inaxeon/Updi-Key/KiCad/Updifier/UpdiKey.pdf

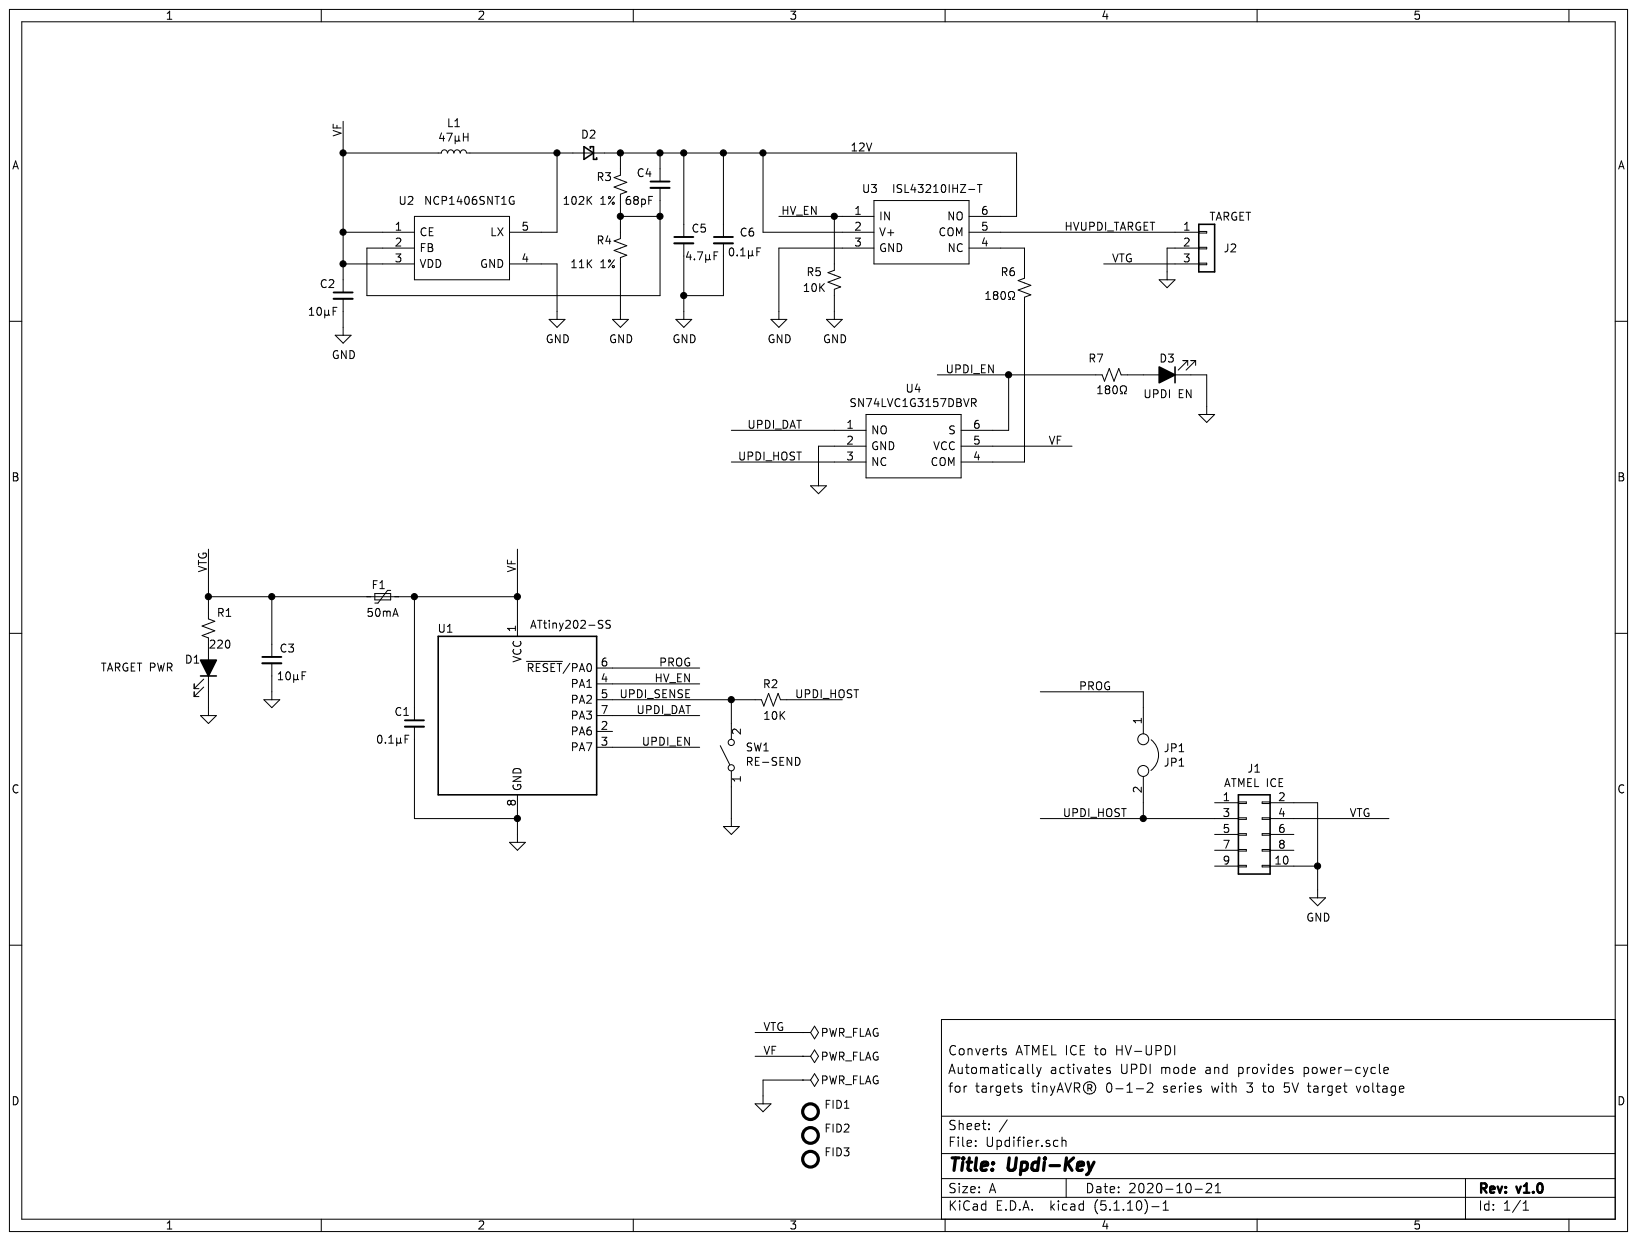
[picture p1: page 1]
