inaxeon/Updi-Key/KiCad/Updifier/Updifier.kicad_pcb

## KiCad design KiCad/Updifier/Updifier.kicad_pcb (2021-10-28)

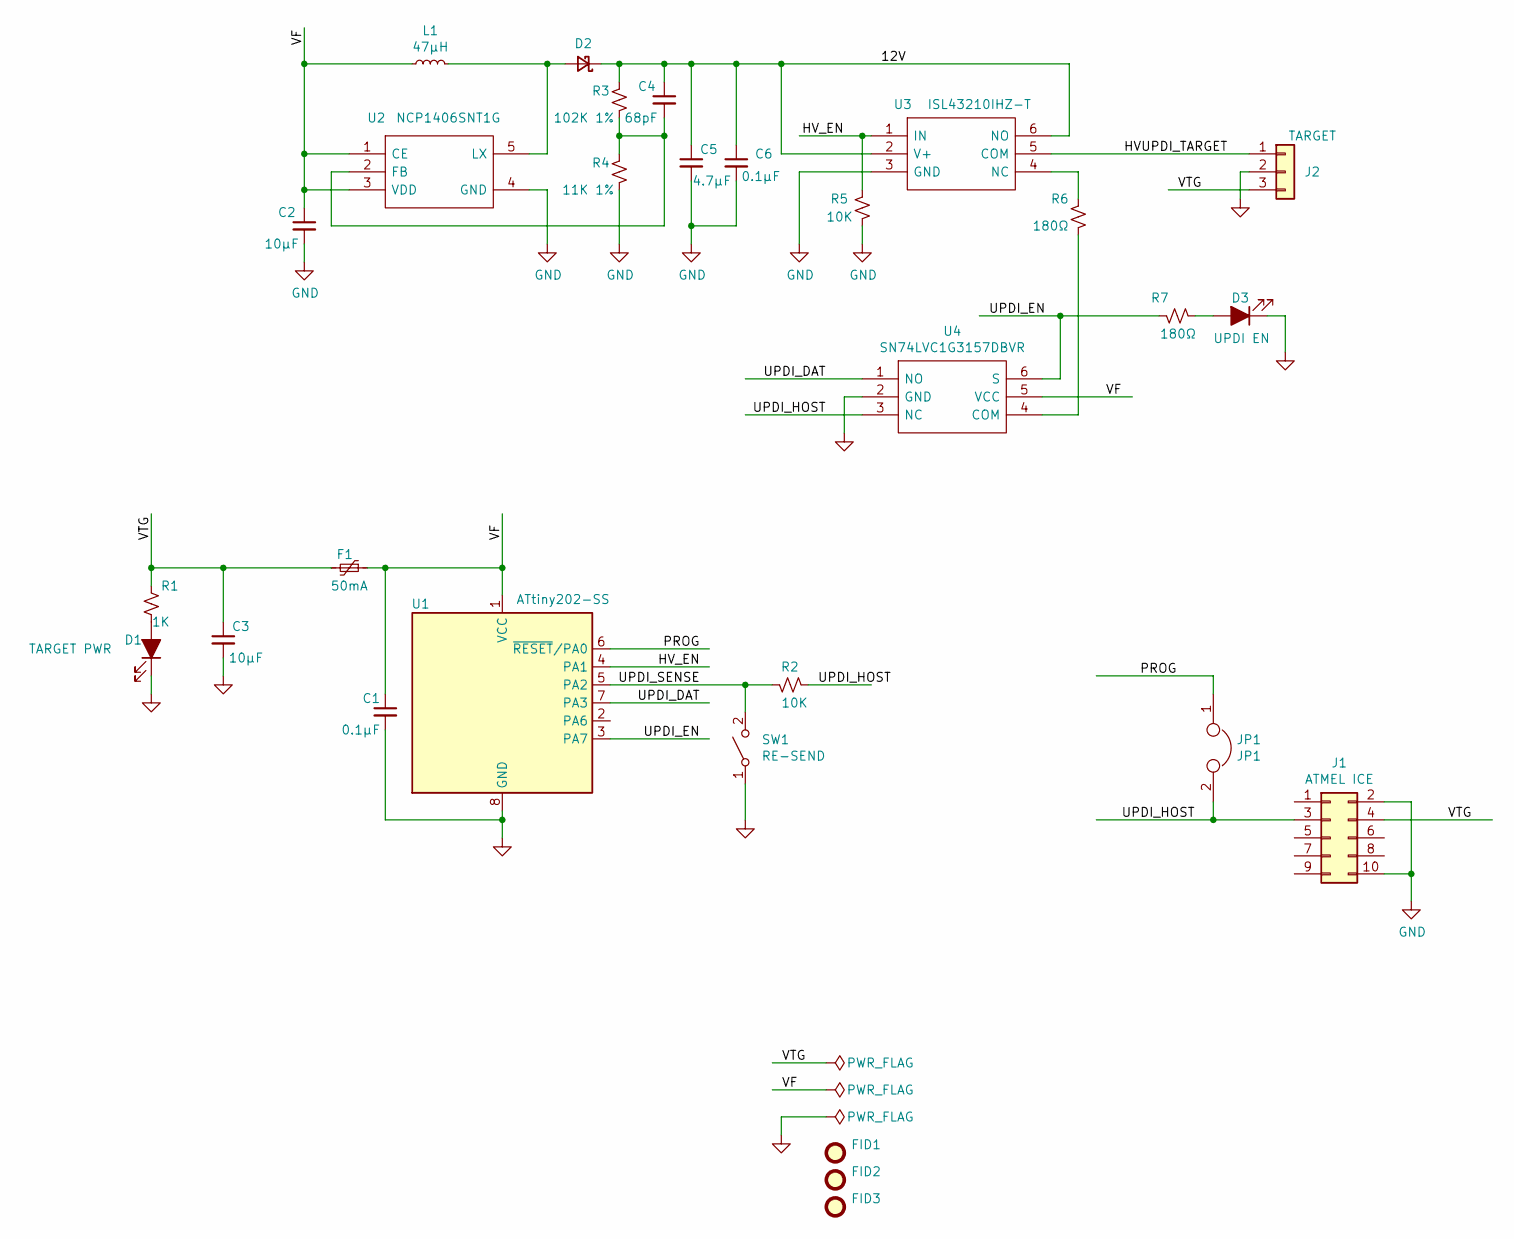
[picture p2: schematic Updifier.sch, Updi-Key]

Parts:
C1, C6: 0.1µF; C_0603_1608Metric; Manufacturer_Part_Number CL10B104KB8NNNC; Digi-Key Part Number 1276-1000-1-ND
C2, C3: 10µF; C_0603_1608Metric; Manufacturer_Part_Number LMK107BBJ106MALT; Digi-Key Part Number 587-3258-1-ND
C4: 68pF; C_0603_1608Metric; Manufacturer_Part_Number CC0603BRNPO9BNR68; Digi-Key Part Number 311-3842-1-ND
C5: 4.7µF; C_0603_1608Metric; Manufacturer_Part_Number CL10A475KO8NNNC; Digi-Key Part Number 1276-1784-1-ND
D1: TARGET PWR; WP934AD; Manufacturer_Part_Number LG Q396-PS-35; Digi-Key Part Number 475-3754-1-ND
D2: PMEG4005CEJX; D_SOD-323F; Manufacturer_Part_Number PMEG4005CEJX; Digi-Key Part Number 1727-8169-1-ND
D3: UPDI EN; WP934AD; Manufacturer_Part_Number APTD1608SECK/J4-PF; Digi-Key Part Number 754-1802-1-ND
F1: 50mA; R_0603_1608Metric; Manufacturer_Part_Number 0ZCM0005FF2G; Digi-Key Part Number 507-1816-1-ND
FID1, FID2, FID3: Fiducial; Fiducial_1mm_Mask2mm
J1: ATMEL ICE; SAMTEC_SHF-105-01-X-D-TH
J2: TARGET; SL_3_RA
JP1: JP1; PinHeader_1x02_P2.00mm_Vertical
L1: 47µH; L_1008_2520Metric; Manufacturer_Part_Number CBC2518T470K; Digi-Key Part Number 587-3060-1-ND
R1: 1K; R_0603_1608Metric; Manufacturer_Part_Number RK73B1JTTD102J; Digi-Key Part Number 2019-RK73B1JTTD102JCT-ND
R2, R5: 10K; R_0603_1608Metric; Manufacturer_Part_Number RK73B1JTTD103J; Digi-Key Part Number 2019-RK73B1JTTD103JCT-ND
R3: 102K 1%; R_0603_1608Metric; Manufacturer_Part_Number RC0603FR-07102KL; Digi-Key Part Number 311-102KHRCT-ND
R4: 11K 1%; R_0603_1608Metric; Manufacturer_Part_Number RC0603FR-0711KL; Digi-Key Part Number 311-11.0KHRCT-ND
R6, R7: 180Ω; R_0603_1608Metric; Manufacturer_Part_Number RK73B1JTTD181J; Digi-Key Part Number 2019-RK73B1JTTD181JCT-ND
SW1: RE-SEND; SW_SPST_B3SL-1002P
U1: ATtiny202-SS; SOIC-8_3.9x4.9mm_P1.27mm; Manufacturer_Part_Number ATTINY202-SSNR; Digi-Key Part Number ATTINY202-SSNRCT-ND
U2: NCP1406SNT1G; SOT-23-5; Manufacturer_Part_Number NCP1406SNT1G; Mouser Part Number 863-NCP1406SNT1G
U3: ISL43210IHZ-T; SOT-23-6; Manufacturer_Part_Number ISL43210IHZ-T; Mouser Part Number 968-ISL43210IHZ-T
U4: SN74LVC1G3157DBVR; SOT-23-6; Manufacturer_Part_Number SN74LVC1G3157DBVR; Mouser Part Number 595-SN74LVC1G3157DBV

Connections:
/12V: C4.1, C5.1, C6.1, D2.1 (K), R3.1, U3.2 (V+), U3.6 (NO)
/HVUPDI_TARGET: J2.1, U3.5 (COM)
/HV_EN: R5.1, U1.4 (PA1), U3.1 (IN)
/PROG: JP1.1, U1.6 (~RESET~/PA0)
/UPDI_DAT: U1.7 (PA3), U4.1 (NO)
/UPDI_EN: R7.2, U1.3 (PA7), U4.6 (S)
/UPDI_HOST: J1.3, JP1.2, R2.2, U4.3 (NC)
/UPDI_SENSE: R2.1, SW1.2 (B), U1.5 (PA2)
/VF: C1.1, C2.1, F1.1, L1.1, U1.1 (VCC), U2.1 (CE), U2.3 (VDD), U4.5 (VCC)
/VTG: C3.1, F1.2, J1.4, J2.3, R1.1
GND: C1.2, C2.2, C3.2, C5.2, C6.2, D1.1 (K), D3.1 (K), J1.2, J1.10, J2.2, R4.2, R5.2, SW1.1 (A), U1.8 (GND), U2.4 (GND), U3.3 (GND), U4.2 (GND)
unnamed: C4.2, R3.2, R4.1, U2.2 (FB)
unnamed: D1.2 (A), R1.2
unnamed: D2.2 (A), L1.2, U2.5 (LX)
unnamed: D3.2 (A), R7.1
unnamed: R6.1, U3.4 (NC)
unnamed: R6.2, U4.4 (COM)

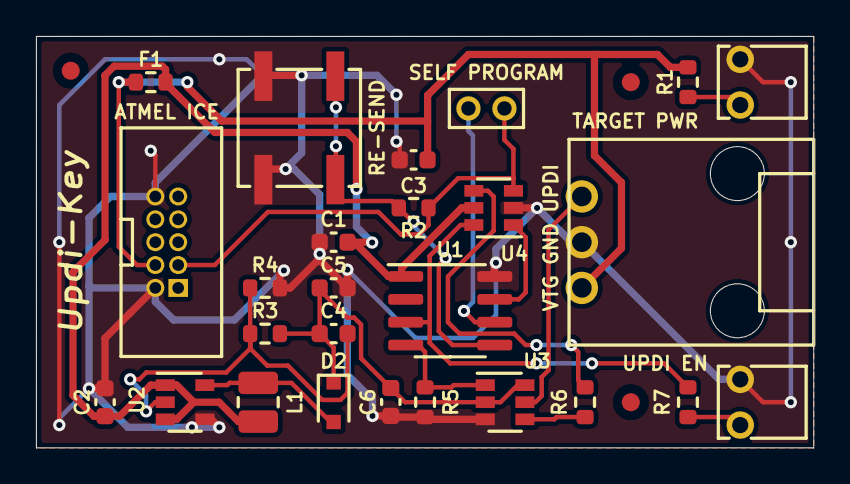
[picture p3: board Updifier.kicad_pcb from above]

Board: 2 copper layers, 43.2 x 22.9 mm, 29 parts (0 on the bottom side), 17 nets.
