inaxeon/Updi-Key/(commit log)

2021-06-13 Reverted back to KiCad 5 footprints. Sorted ATMEL ICE pinout mess
2021-06-14 Layout WIP
    [Updifier.kicad_pcb, Updifier.sch]
2021-10-28 Post build fixes
    [Updifier.kicad_pcb, Updifier.sch]
